TinyCircuits/TinyCircuits-RobotZero-ASM2027/images/ASM2027-Tutorial-Animation-01.gif

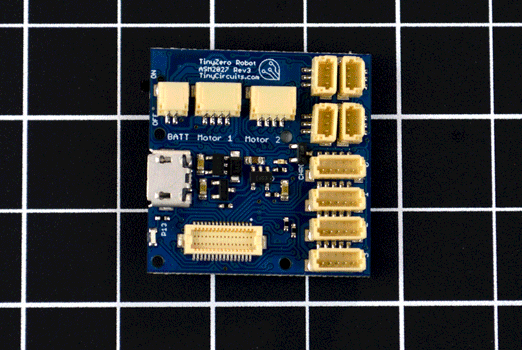
images/ASM2027-Tutorial-Animation-01.gif
