TinyCircuits/TinyCircuits-RobotZero-ASM2027/README.md

# TinyCircuits RobotZero ASM2027
# ASM2026 Rev3

The design files are located under design_files/ for the TinyCircuits ASM2027 Rev 4 PCB, and Rev3 schematic pdf. This is a processor board with several different connectors (for Motors, Servos, and [Wirelings](https://tinycircuits.com/pages/wireling-overview)) that add a great range of customizable functionality.

Format is in Cadsoft Eagle format - Eagle version 6.2 was used for the original design.

For more infomation on this, check out the product page at TinyCircuits.com

# License:

Design by TinyCircuits.
All design files are released under the Creative Commons Attribution Share-Alike 3.0 License, see the following link for details: http://creativecommons.org/licenses/by-sa/3.0

All text above must be included in any redistribution or derived design

This project uses designs and concepts developed as part of the Arduino project and the LilyPad project.  The TinyCircuits design files themselves (schematics, PCB and libraries) are not directly derived from these works' design files and have been created new, however the concepts and basic architecture behind the TinyDuino and TinyLily products are derived and we thank the hard work of the organizations below for their contributions to open-source hardware:
  
Original Arduino Uno Design by Team Arduino

LilyPad Arduino Design by Leah Buechley and Sparkfun Electronics

Please support the open-source hardware community
