TinyCircuits/TinyCircuits-RobotZero-ASM2027/cad/RobotZero_ASM2027_REV3-DETAILED_DRAWING_COMPACT-PNG.png

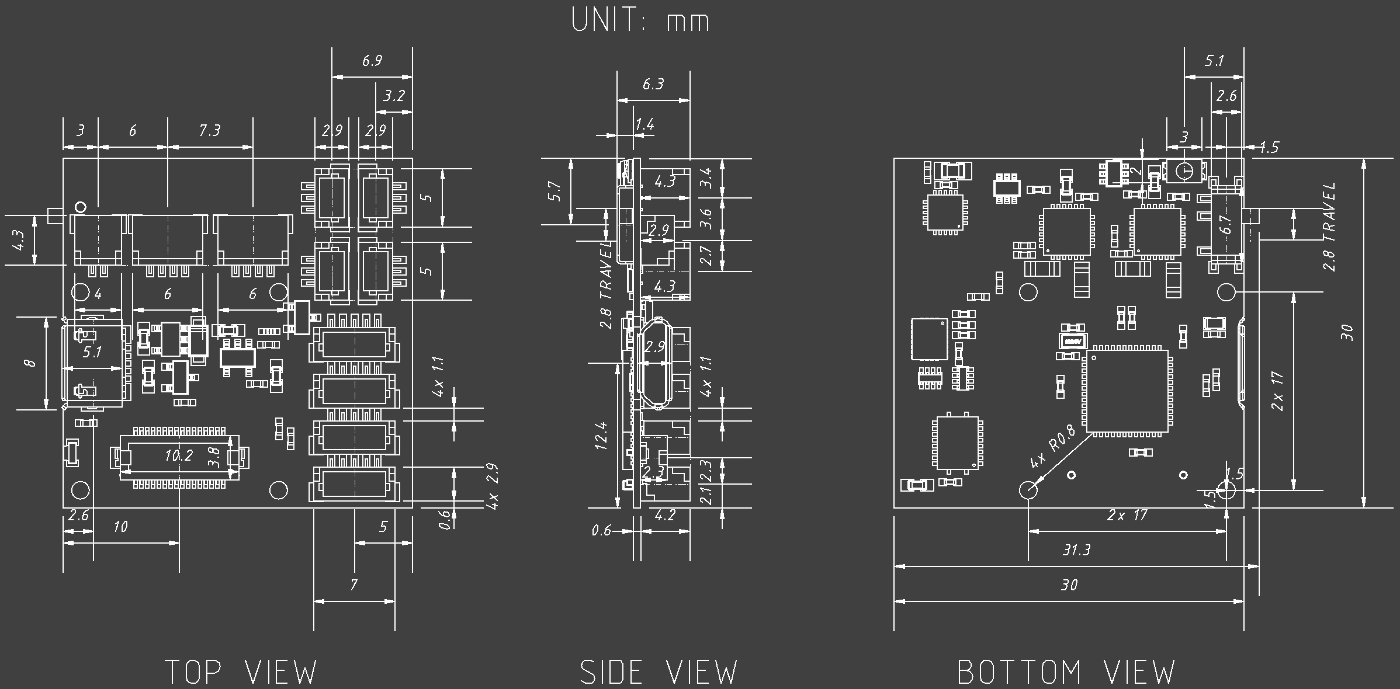
cad/RobotZero_ASM2027_REV3-DETAILED_DRAWING_COMPACT-PNG.png
