TinyCircuits/TinyCircuits-RobotZero-ASM2027/images/Rev3-DC-Motor-Modification/RobotZero-DCMotor-pins.jpg

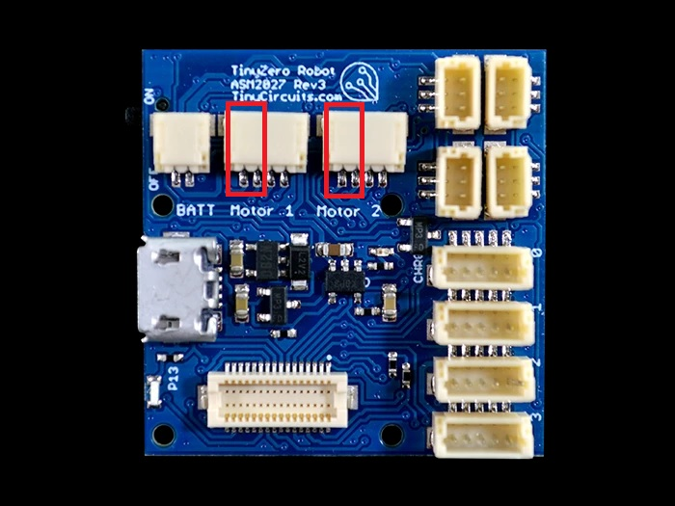
images/Rev3-DC-Motor-Modification/RobotZero-DCMotor-pins.jpg
