TinyCircuits/TinyCircuits-RobotZero-ASM2027/images/Rev3-DC-Motor-Modification/RobotZero-DCMotor-traces-to-cut.jpg

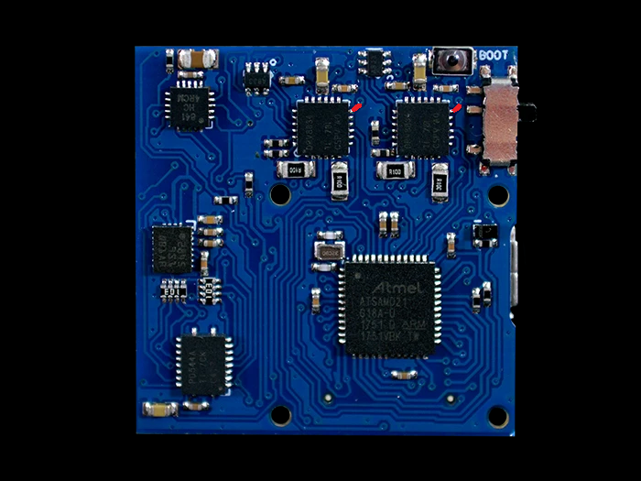
images/Rev3-DC-Motor-Modification/RobotZero-DCMotor-traces-to-cut.jpg
