TinyCircuits/TinyCircuits-RobotZero-ASM2027/(list of files, cad)

Other CAD files:
cad/RobotZero_ASM2027_REV3-DETAILED_DRAWING-DXF.dxf
