TinyCircuits/TinyCircuits-RobotZero-ASM2027/design_files/ASM2027.pdf

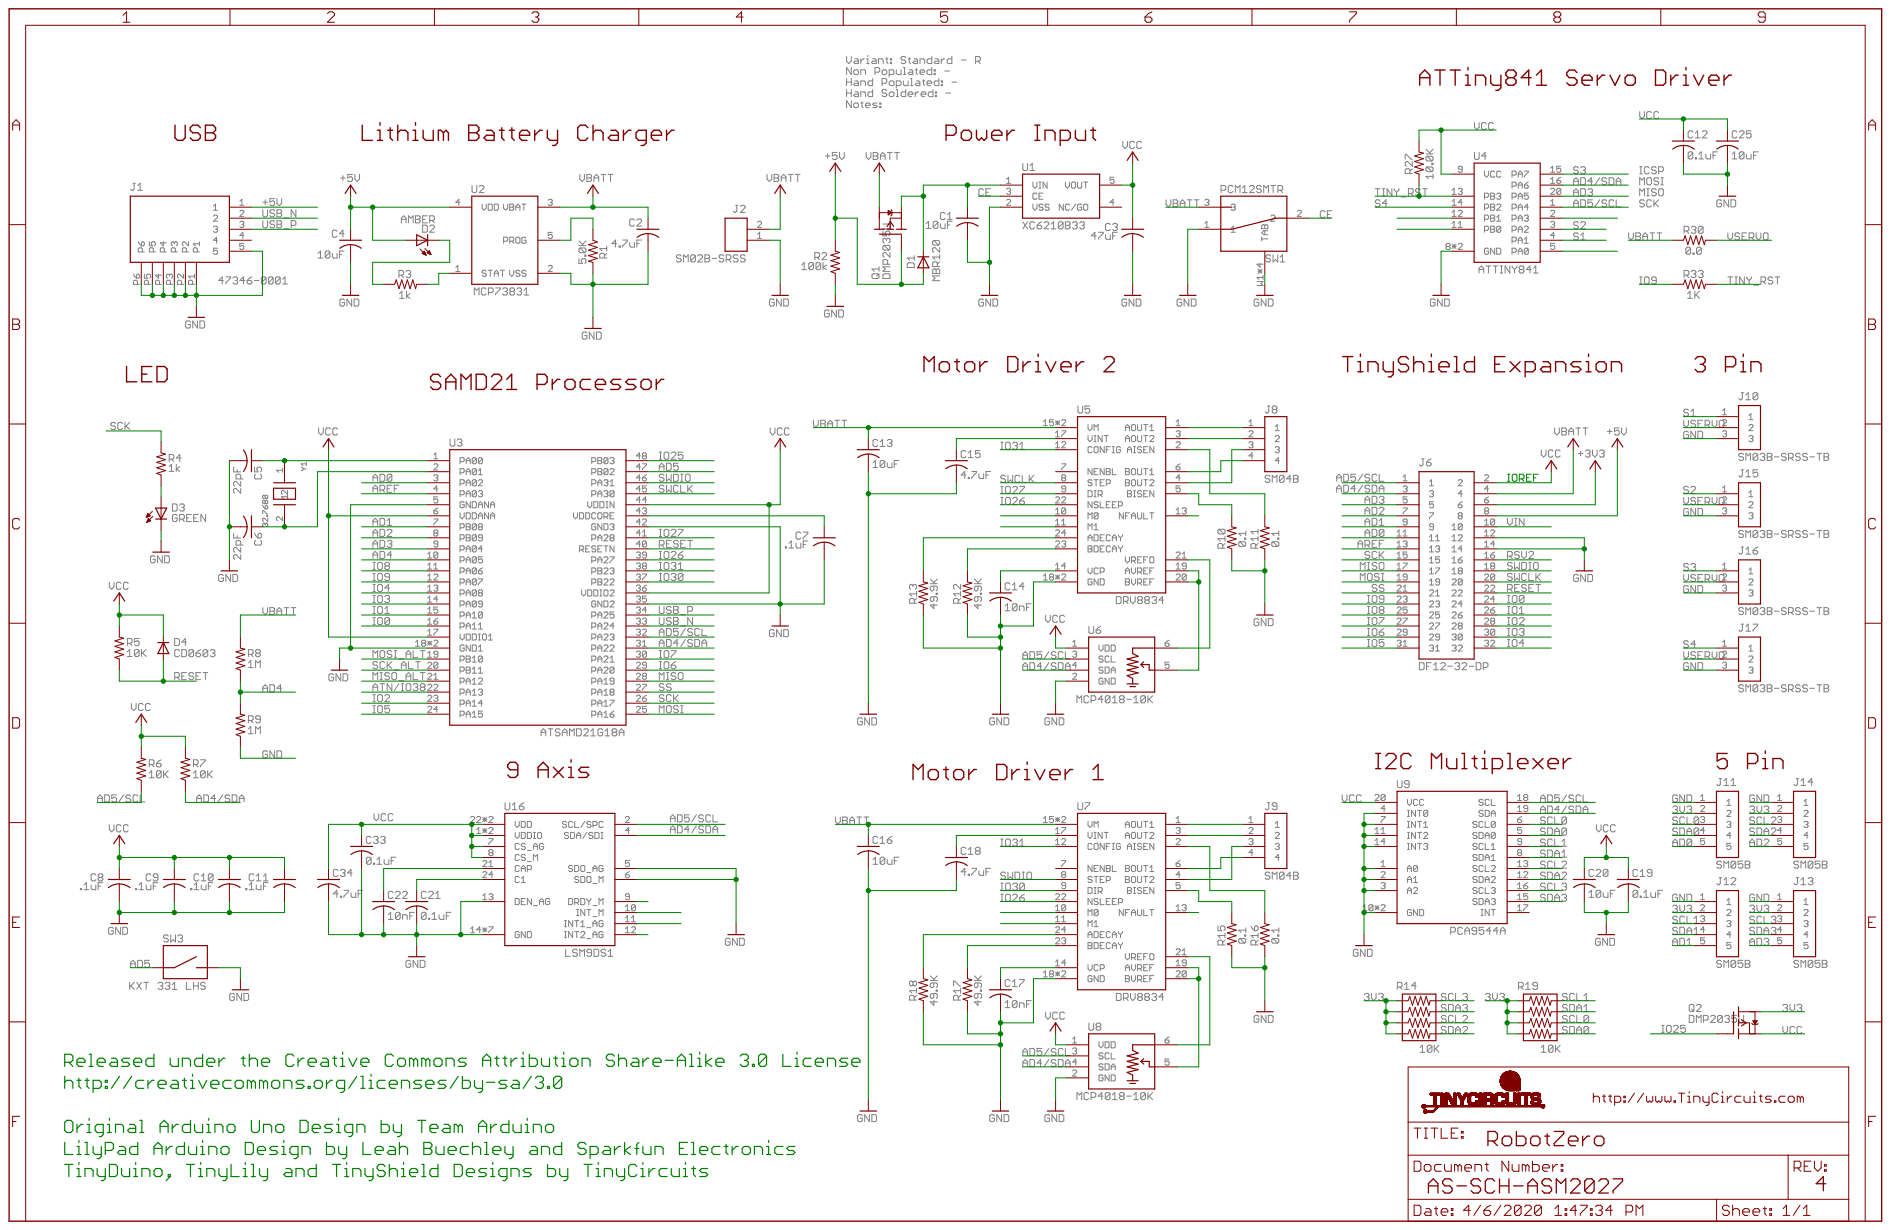
[picture p7: page 1]
