TinyCircuits/TinyCircuits-RobotZero-ASM2027/design_files/ASM2027-Rev3.pdf

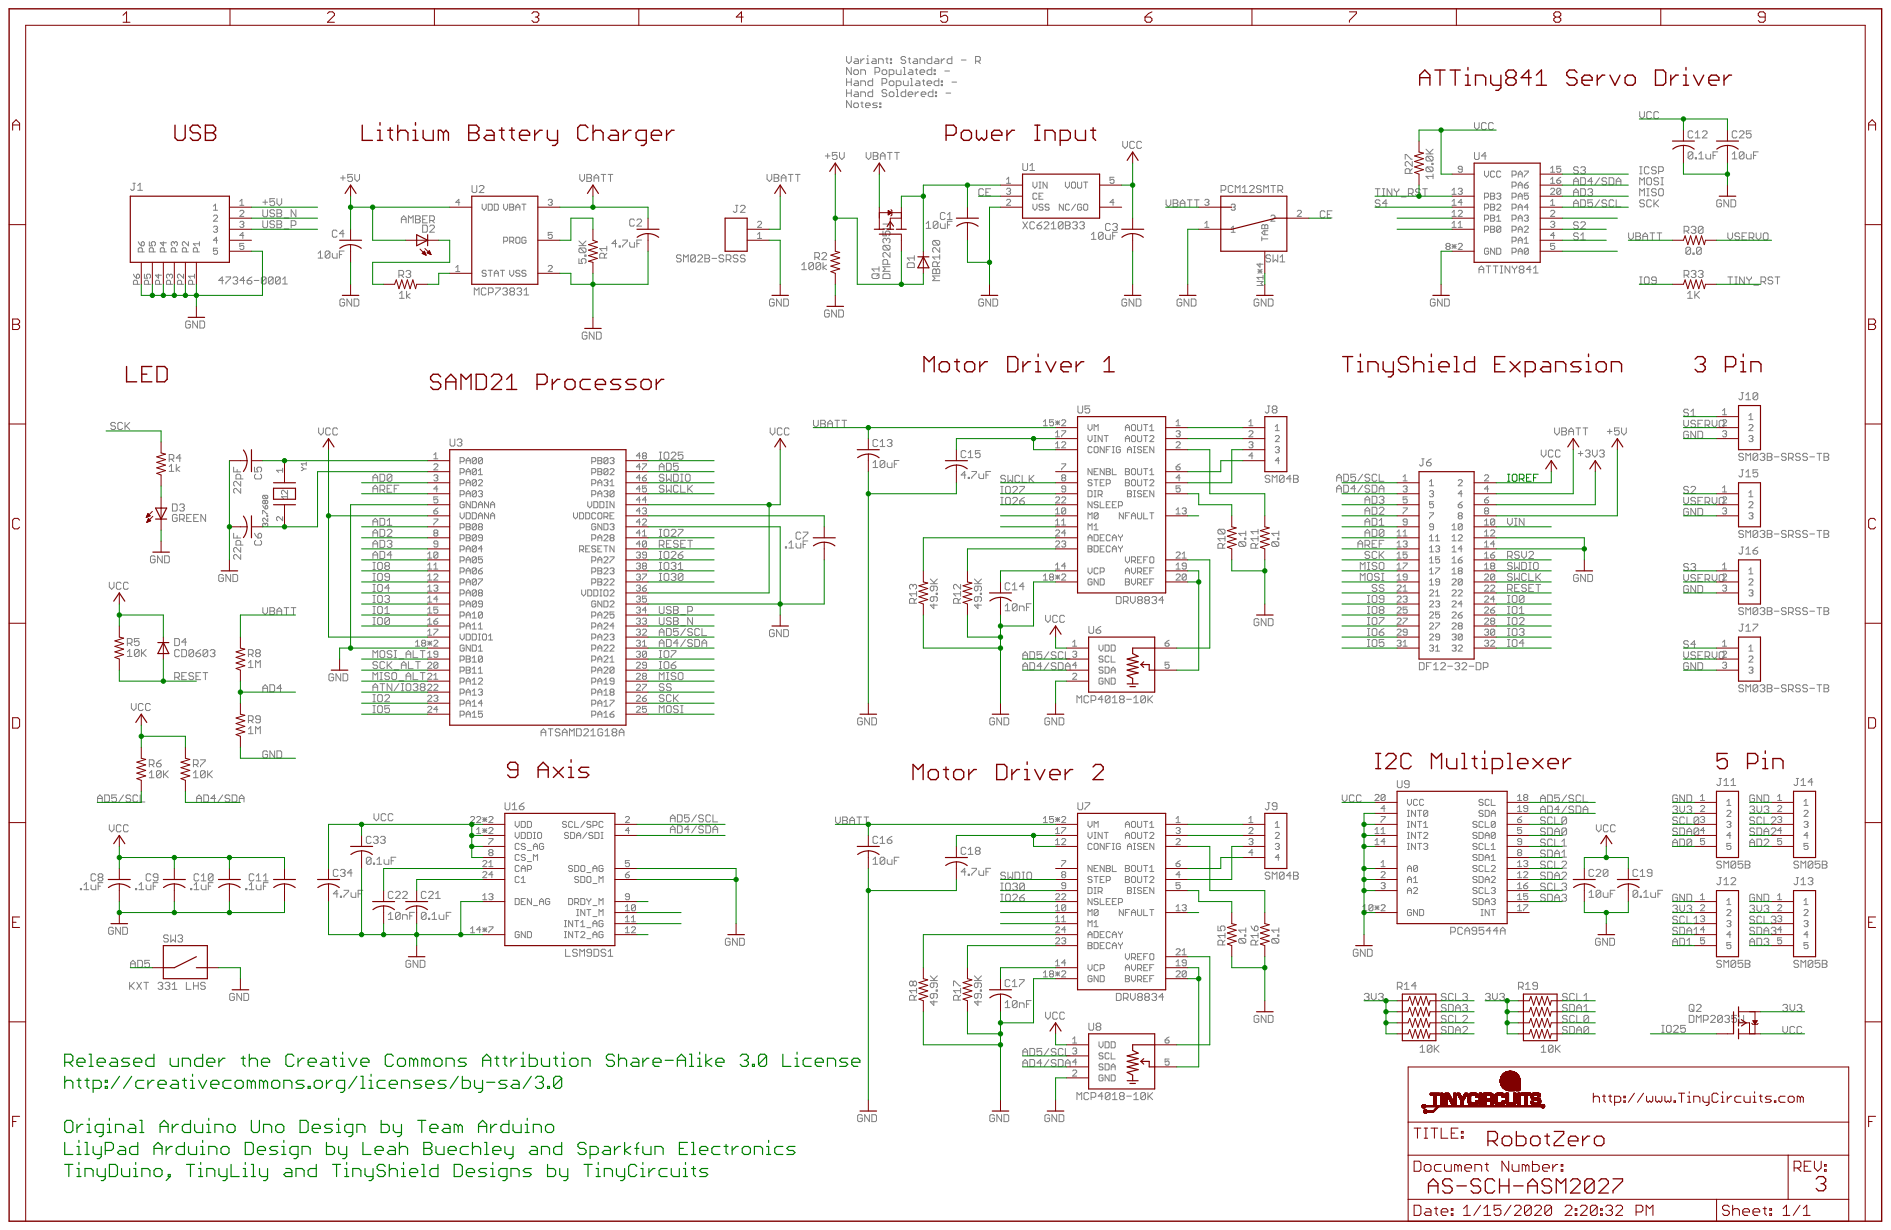
[picture p8: page 1]
