TinyCircuits/TinyCircuits-RobotZero-ASM2027/images/ASM2027-Tutorial-Image-02.png

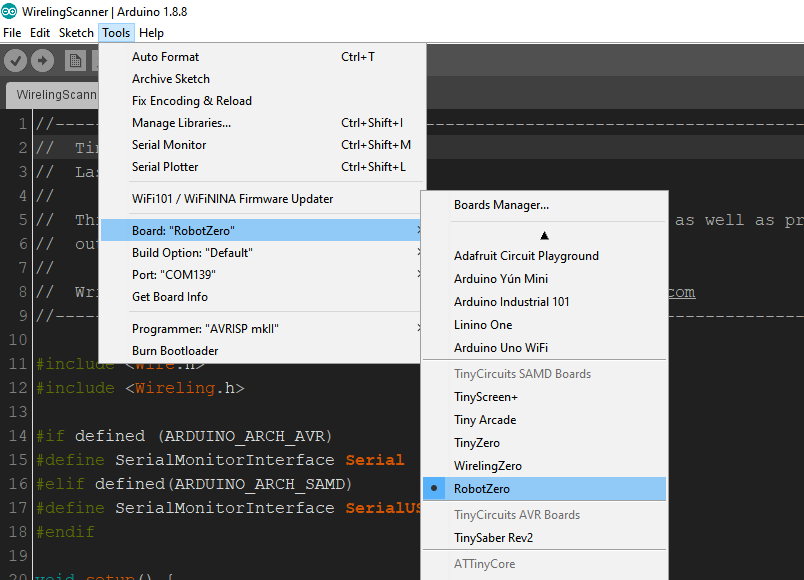
images/ASM2027-Tutorial-Image-02.png
