TinyCircuits/TinyCircuits-RobotZero-ASM2027/images/ASM2027-Tutorial-Image-03.png

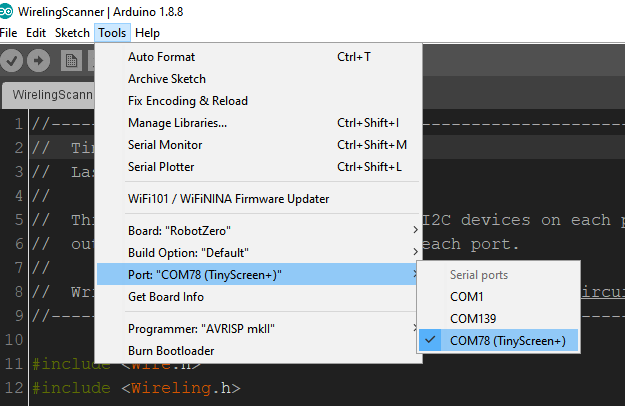
images/ASM2027-Tutorial-Image-03.png
