TinyCircuits/TinyCircuits-RobotZero-ASM2027/(threads)

Thread 1 (2020-03-17):

VSERVO cannot be switched off

AlanKilian, 2020-03-17:
It is not possible to remove the power supply connection to the servos.
VBATT is ties directly to VSERVO through the zero Ohm resistor R30

This means either the servos or the battery need to be unplugged to avoid draining the battery when the device is unused.

A possible solution would be to increase the current capacity of SW1, connect the CE net to the VSERVO net and add a diode from VSERVO to ground to suppress possible back EMF from the servos when the switch is opened. I have not simulated or tested this possible solution.

Another possible solution is to replace the SPDT SW1 with a DPDT switch so that the VBATT to VSERVO can be disconnected at the same time VBATT to CE is disconnected.

SW1 does not need to be double-throw if CE has a pull-down resistor, so a DPST version can be substituted depending on availability, cost and size.

TinyCircuits, 2020-03-27:
Thank you for the good suggestions.

Unfortunately, the current design is due to limitations of the hardware, and were made intentionally due to the PCB size.

We will try to look into some solutions. Perhaps an inline power switch.

Thread 2 (2020-03-21):

Motor 1 and 2 silk is swapped

AlanKilian, 2020-03-21:
Schematic shows J8 connected to motor driver #1, but the silk says "Motor 2"
Schematic shows J9 connected to motor driver #2, but the silk says "Motor 1"

Possible fix in stepper.ino is to update the pin numbers:
const int stepPin1 = 45;
const int dirPin1 = 30;
const int stepPin2 = 44;
const int dirPin2 = 27;

TinyCircuits, 2020-03-27:
We will update the software soon. Thanks for the catch!
