TinyCircuits/TinyCircuits-RobotZero-ASM2027/(commit log)

2020-01-15 design & pics
    [ASM2027.brd, ASM2027.sch]
2020-03-02 servo example
2020-06-26 Add CAD data
2020-06-29 Rename files and use different 2D drawing template
    [RobotZero_ASM2027_DXF_REV3.dxf]
2020-06-30 Add compact dimensions in dark & light, and remove vias from models/drawings
    [RobotZero_ASM2027_DXF_REV3.dxf, RobotZero_DXF_ASM2027_REV3.dxf]
2020-07-02 Add zip of all CAD files
2020-08-18 Update CAD drawings
    [RobotZero_ASM2027_REV3-DETAILED_DRAWING-DXF.dxf, RobotZero_DXF_ASM2027_REV3.dxf]
2020-09-30 add DC motor instructions
2020-11-19 dc motor updates
    [ASM2027-Rev3.brd, ASM2027-Rev3.sch]
2022-01-18 fix motor datasheets and update hardware files
    [ASM2027-Rev3.brd, ASM2027-Rev3.sch]
